maehem/BlueLEDBoard/daughterboard/blueled-daughter-board-sch.png

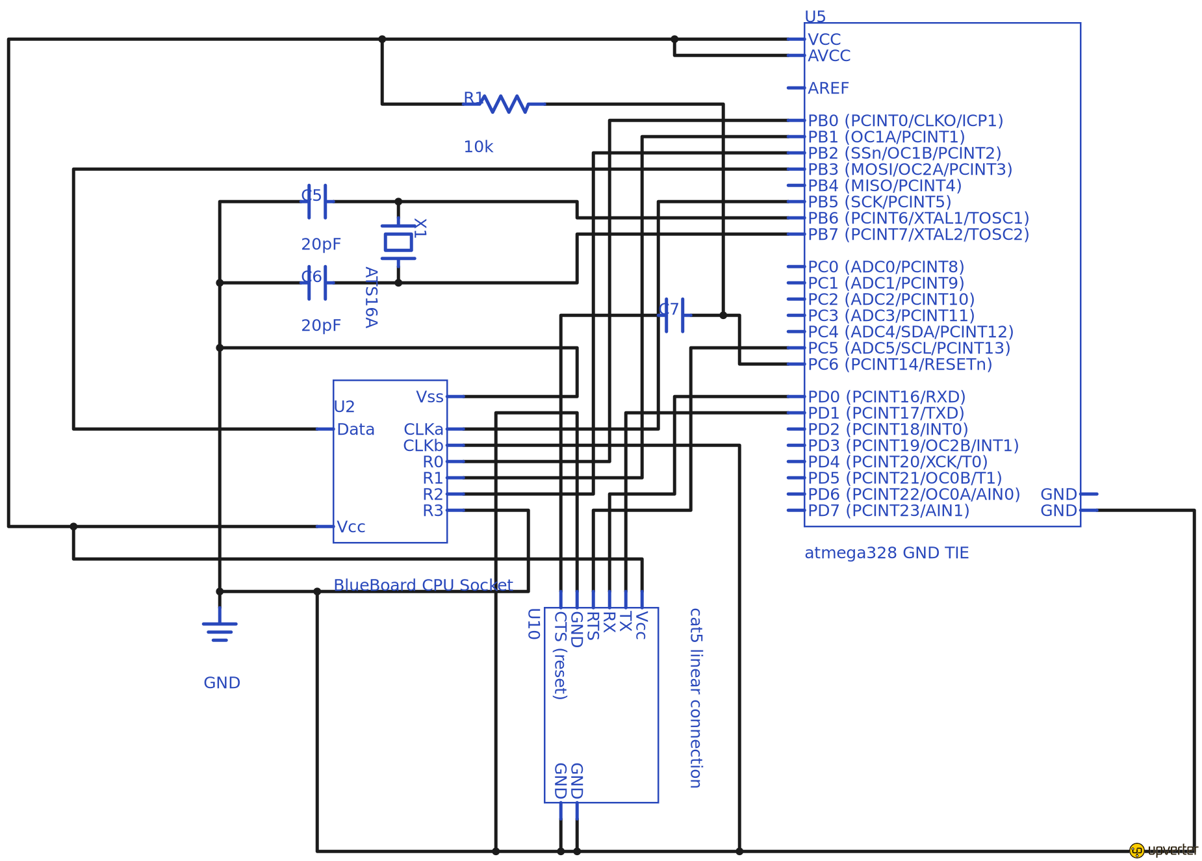
daughterboard/blueled-daughter-board-sch.png
