maehem/BlueLEDBoard/daughterboard2/Documents/blue-led-2-bom.ods

Blue LED Board 2 |  | Rev.A
Part | Value | Device | Description | COST01 | COST10 | COST100 | MFR | MPN
FAB | OSH Park Fab |  | FAB | $2.50 | $2.00 | $0.50
XTAL | 16MHz | 2P3.2X2.5 | Crystal | $0.50 | $0.40 | $0.30 | Epson | FA-238 16.0000MB-K3
CPU | ATmega328P-MU | ATMEGA328MU | Atmega 328P | $3.00 | $2.00 | $1.60 | Atmel | atmega328p-mu
C1 | 12pF | CAPACITOR0603 | Capacitor | $0.12 | $0.09 | $0.05
C2 | 12pF | CAPACITOR0603 | Capacitor | $0.12 | $0.09 | $0.05
C3 | 1uF | CAPACITOR0603 | Capacitor | $0.12 | $0.09 | $0.05
C4 | 0.1uF | CAPACITOR0603 | Capacitor | $0.12 | $0.09 | $0.05
C6 | 0.1uF | CAPACITOR0603 | Capacitor | $0.12 | $0.09 | $0.05
J5 | 3P, Male, Breakaway, 2.54mm | CON_03X1-2.54MM-THD-VT | Header, 3-pin, single row | $0.15 | $0.11 | $0.08
J6 | 3P, Male, Breakaway, 2.54mm | CON_03X1-2.54MM-THD-VT | Header, 3-pin, single row | $0.15 | $0.11 | $0.08
J8 | Header, 0.1in, THD, 03Px2 | CON_03X2-VT_SMD | Header, 3x2 (6-pin) | $0.30 | $0.25 | $0.19
J1 | Header, 0.1in, THD, 04P | CON_04X1-THD-VT | Headers, 04 pin | $0.20 | $0.16 | $0.11 | Molex | 22284043
J2 | Header, 0.1in, THD, 04P | CON_04X1-THD-VT | Headers, 04 pin | $0.20 | $0.16 | $0.11 | Molex | 22284043
J3 | Header, 0.1in, THD, 04P | CON_04X1-THD-VT | Headers, 04 pin | $0.20 | $0.16 | $0.11 | Molex | 22284043
J4 | Header, 0.1in, THD, 04P | CON_04X1-THD-VT | Headers, 04 pin | $0.20 | $0.16 | $0.11 | Molex | 22284043
J7 | NanoFit, 04P, RA | NANOFIT-04P-SR-RA | Molex, Nanofit | $1.40 | $1.10 | $1.00 | Molex | 105313-XX04
R1 | 10K | RESISTOR0603 | Resistor | $0.10 | $0.05 | $0.02
R2 | 1K | RESISTOR0603 | Resistor | $0.10 | $0.05 | $0.02
R3 | 1K | RESISTOR0603 | Resistor | $0.10 | $0.05 | $0.02
R4 | 1K | RESISTOR0603 | Resistor | $0.10 | $0.05 | $0.02
 |  |  | Cost: | $9.80 | $7.26 | $4.52
