maehem/BlueLEDBoard/daughterboard2/PCB/blue-led-2.brd

## EAGLE design daughterboard2/PCB/blue-led-2.brd (2022-05-30)

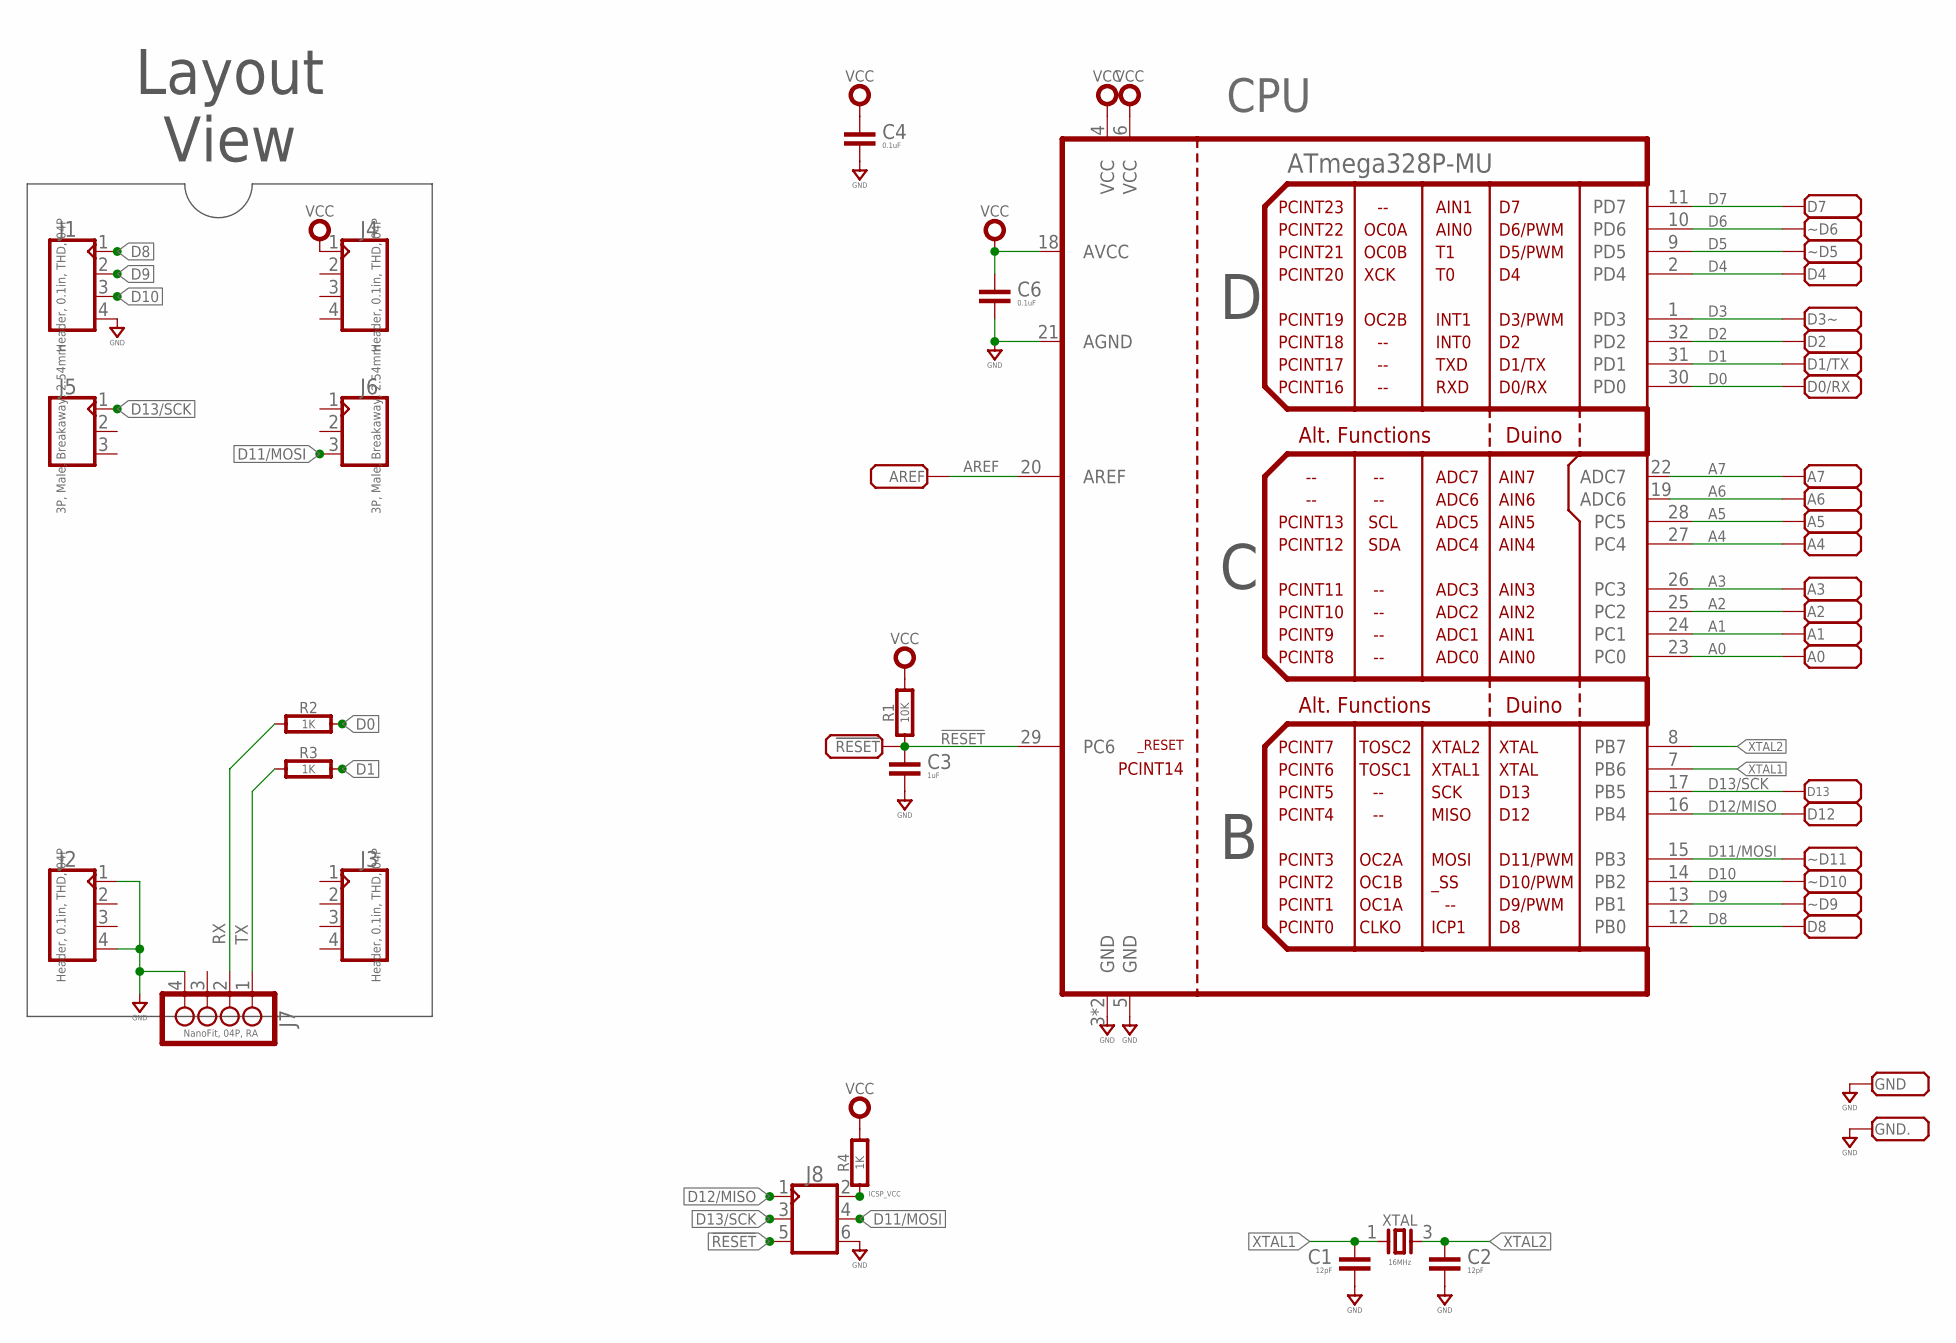
[picture p2: schematic blue-led-2.sch]

Parts:
!RESET: PADSMD-050X050; SMD-050X050
A0, A1, A2, A3, A4, A5, A6, A7: PADSMD-050X050; SMD-050X050
AREF: PADSMD-050X050; SMD-050X050
C1, C2: 12pF; 0603-CAP
C3: 1uF; 0603-CAP
C4, C6: 0.1uF; 0603-CAP
CPU: ATmega328P-MU; MLF32
D0/RX, D1/TX, D2, D3~, D4, D7, D8, D12, D13: PADSMD-050X050; SMD-050X050
GND, GND.: PADSMD-050X050; SMD-050X050
J1, J2, J3, J4: Header, 0.1in, THD, 04P; MA04X1-VT-THD
J5, J6: 3P, Male, Breakaway, 2.54mm; MA03X1-VT-THD
J7: NanoFit, 04P, RA; MOLEX-105313-XX04
J8: CON_03X2-VT_SMD; MA03X2-VT-SMD
R1: 10K; 0603-RES
R2, R3, R4: 1K; 0603-RES
XTAL: 16MHz; 32X25
~D5, ~D6, ~D9, ~D10, ~D11: PADSMD-050X050; SMD-050X050

Connections:
!RESET: !RESET.1, C3.1, CPU.29 (PC6), J8.5, R1.1
A0: A0.1, CPU.23 (PC0)
A1: A1.1, CPU.24 (PC1)
A2: A2.1, CPU.25 (PC2)
A3: A3.1, CPU.26 (PC3)
A4: A4.1, CPU.27 (PC4)
A5: A5.1, CPU.28 (PC5)
A6: A6.1, CPU.19 (ADC6)
A7: A7.1, CPU.22 (ADC7)
AREF: AREF.1, CPU.20 (AREF)
D0: CPU.30 (PD0), D0/RX.1, R2.2
D1: CPU.31 (PD1), D1/TX.1, R3.2
D2: CPU.32 (PD2), D2.1
D3: CPU.1 (PD3), D3~.1
D4: CPU.2 (PD4), D4.1
D5: CPU.9 (PD5), ~D5.1
D6: CPU.10 (PD6), ~D6.1
D7: CPU.11 (PD7), D7.1
D8: CPU.12 (PB0), D8.1, J1.1
D9: CPU.13 (PB1), J1.2, ~D9.1
D10: CPU.14 (PB2), J1.3, ~D10.1
D11/MOSI: CPU.15 (PB3), J6.3, J8.4, ~D11.1
D12/MISO: CPU.16 (PB4), D12.1, J8.1
D13/SCK: CPU.17 (PB5), D13.1, J5.1, J8.3
GND: C1.2, C2.2, C3.2, C4.2, C6.2, CPU.3 (GND), CPU.5 (GND), CPU.21 (AGND), CPU.PAD (GND), GND.1, GND..1, J1.4, J2.1, J2.4, J7.4, J8.6
ICSP_VCC: J8.2, R4.1
RX: J7.2, R2.1
TX: J7.1, R3.1
VCC: C4.1, C6.1, CPU.4 (VCC), CPU.6 (VCC), CPU.18 (AVCC), J4.1, R1.2, R4.2
XTAL1: C1.1, CPU.7 (PB6), XTAL.1
XTAL2: C2.1, CPU.8 (PB7), XTAL.3

Notes on the sheet:
Layout View

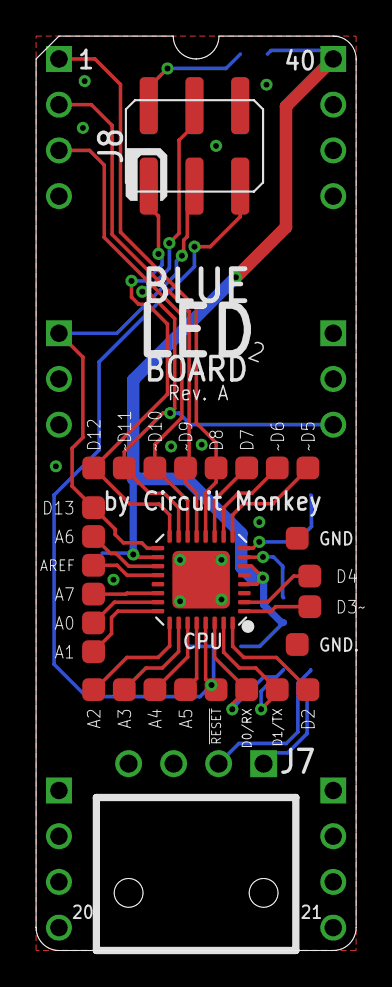
[picture p3: board blue-led-2.brd from above]

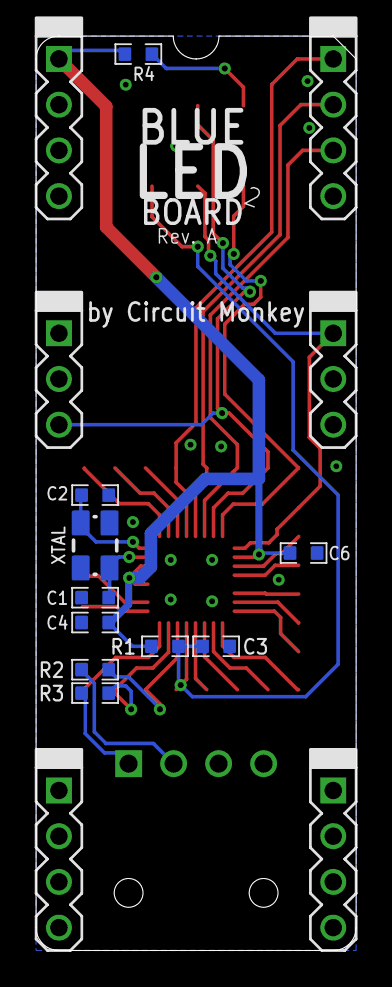
[picture p4: board blue-led-2.brd from below]

Board: 2 copper layers, 17.8 x 50.8 mm, 45 parts (16 on the bottom side), 31 nets.
