maehem/BlueLEDBoard/(commit log)

2022-05-24 Merge original schematic for daughter board.
    Pulled from other archive location.
2022-05-29 Update descriptions and git-ignore of some PCB CAD files.
2022-05-30 Rev.A pre-fab. final?
    [blue-led-2.brd, blue-led-2.sch]
2022-05-30 PDF version of BOM
    [blue-led-2-bom.ods]
